semianalog/sf/README

Audio non-contact shortfinder

Still a prototype
