semianalog/sf/sf.kicad_pcb

## KiCad design sf.kicad_pcb (2017-08-20)

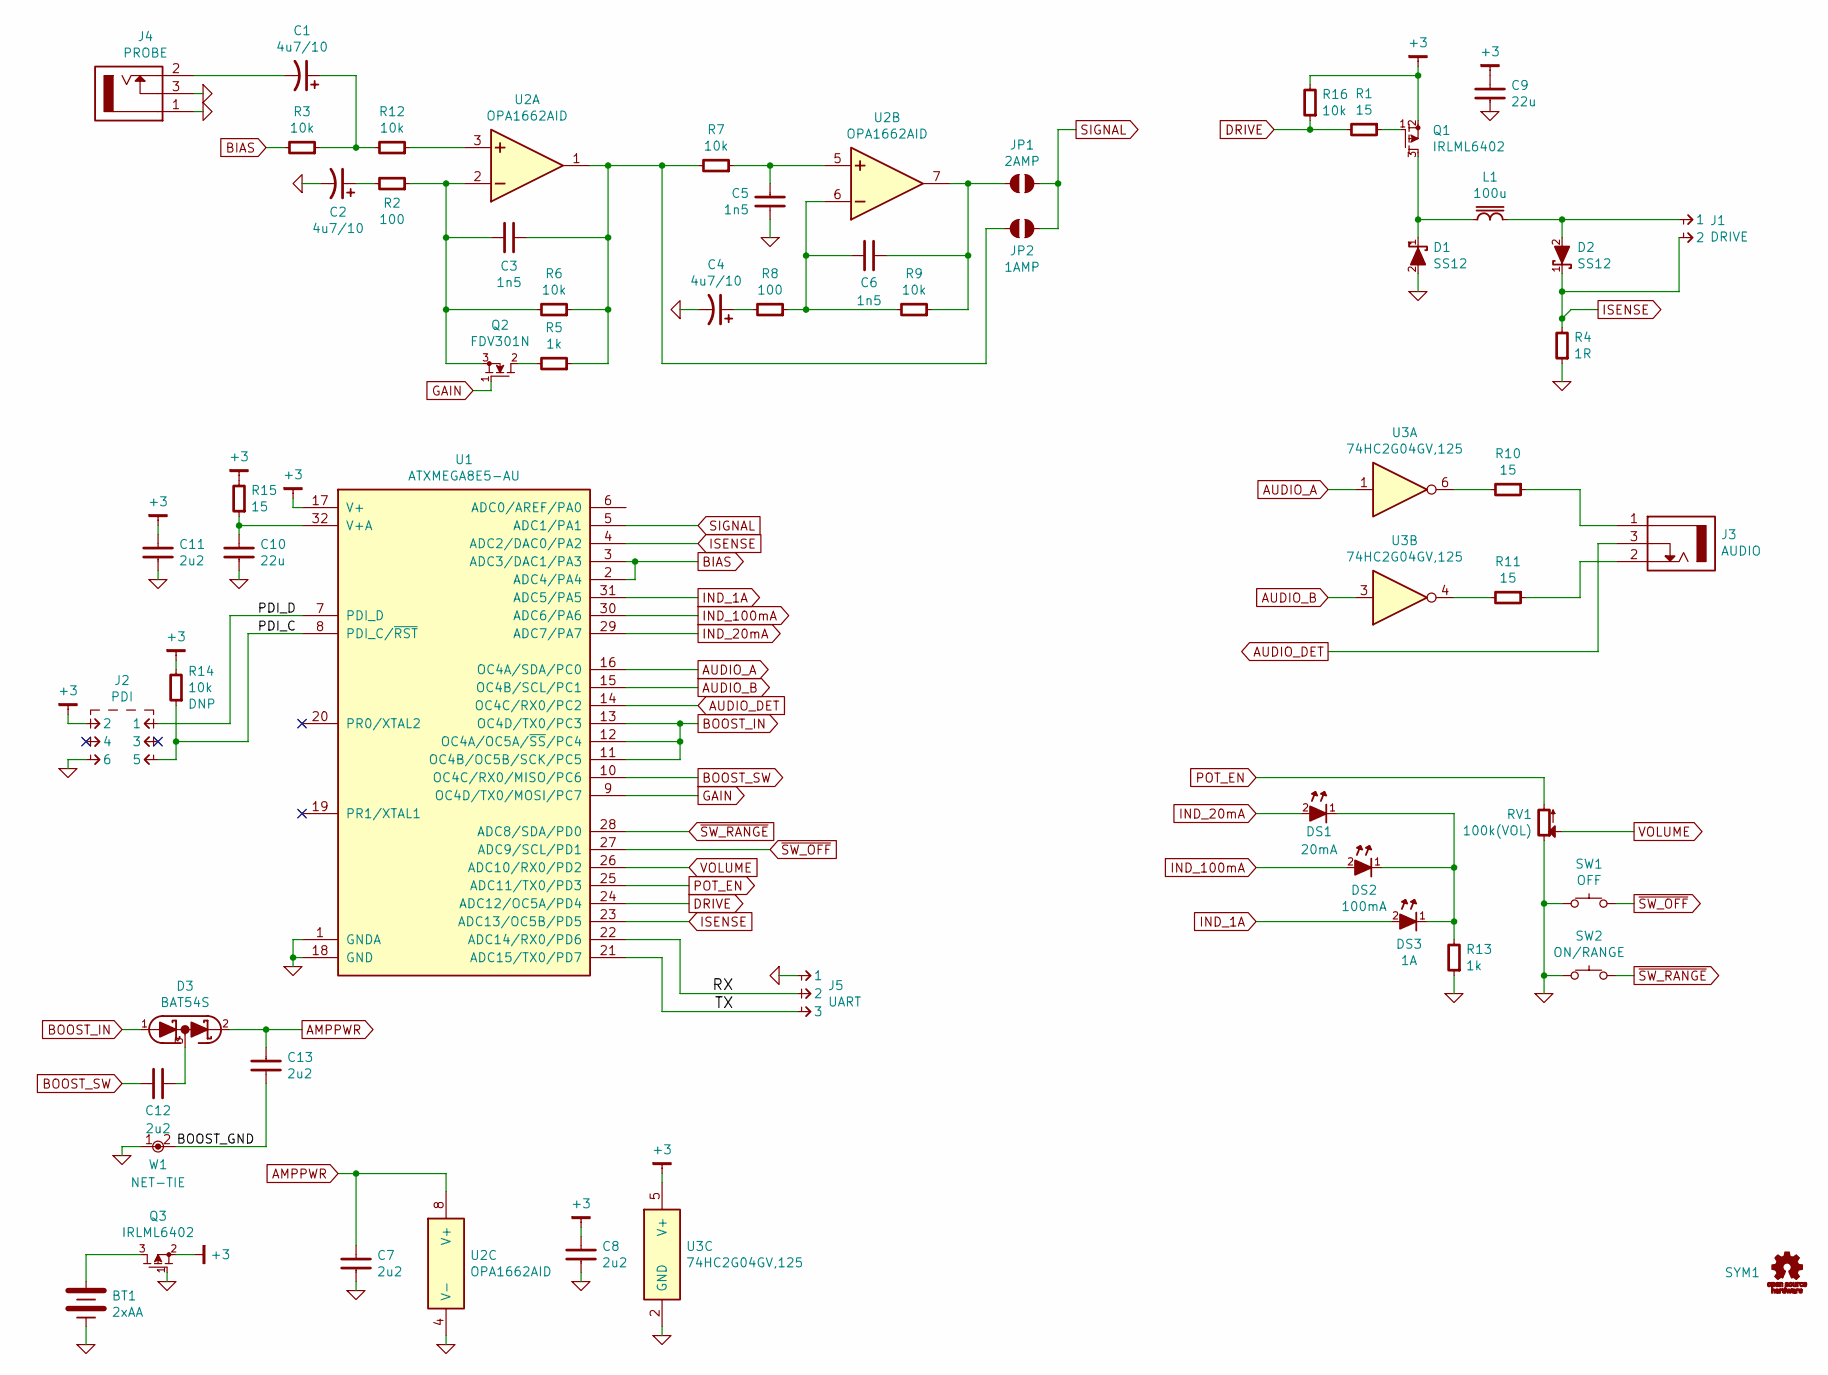
[picture p1: schematic sf.sch, Non-contact audio shortfinder]

Parts:
BT1: 2xAA
C1, C2, C4: 4u7/10; CAPMP2013X120; MPN F921A475MPA
C3, C5, C6: 1n5; CAPC2012X70
C7, C8, C11, C12, C13: 2u2; CAPC2012X70
C9, C10: 22u; CAPC3216X70
D1, D2: SS12; DIOM5326X292
D3: BAT54S; SOT-23
DS1: 20mA; LED-0603
DS2: 100mA; LED-0603
DS3: 1A; LED-0603
J1: DRIVE; CONN-100MIL-M-1x2
J2: PDI; CONN-100MIL-M-2x3
J3: AUDIO
J4: PROBE
J5: UART; CONN-100MIL-M-1x3
JP1: 2AMP; JUMPER-SOLDER-SMD
JP2: 1AMP; JUMPER-SOLDER-SMD
L1: 100u; BOURNS-RLB0914
Q1, Q3: IRLML6402; SOT-23
Q2: FDV301N; SOT-23
R1, R10, R11, R15: 15; RESC2012X50
R2, R8: 100; RESC2012X50
R3, R6, R7, R9, R12, R14, R16: 10k; RESC2012X50
R4: 1R; RESC3216X60
R5, R13: 1k; RESC2012X50
RV1: 100k(VOL); MPN 3352T-1-104LF
SW1: OFF; TE-FSMSM
SW2: ON/RANGE; TE-FSMSM
SYM1: OSHW-SCHEM-PCB6mm; OSHW-6mm
U1: ATXMEGA8E5-AU; QFP80P900X900X120-32; MPN ATXMEGA8E5-AU
U2: OPA1662AID; SOIC127P600X175-8; MPN OPA1662AID
U3: 74HC2G04GV,125; SOT-23-6; MPN 74HC2G04GV,125
W1: NET-TIE; NET-TIE-1mm

Connections:
+3: C8.1, C9.1, C11.1, J2.2, Q1.2 (S), Q3.2 (S), R14.2, R15.2, R16.2, U1.17 (V+), U3.5 (V+)
/BOOST_GND: C13.1, W1.2
/PDI_C: J2.5, R14.1, U1.8 (PDI_C/~RST)
/PDI_D: J2.1, U1.7 (PDI_D)
/RX: J5.2, U1.22 (ADC14/RX0/PD6)
/TX: J5.3, U1.21 (ADC15/TX0/PD7)
AMPPWR: C7.1, C13.2, D3.2 (K), U2.8 (V+)
AUDIO_A: U1.16 (OC4A/SDA/PC0), U3.1
AUDIO_B: U1.15 (OC4B/SCL/PC1), U3.3
AUDIO_DET: J3.3, U1.14 (OC4C/RX0/PC2)
BIAS: R3.2, U1.2 (ADC4/PA4), U1.3 (ADC3/DAC1/PA3)
BOOST_IN: D3.1 (A), U1.11 (OC4B/OC5B/SCK/PC5), U1.12 (OC4A/OC5A/~SS~/PC4), U1.13 (OC4D/TX0/PC3)
BOOST_SW: C12.2, U1.10 (OC4C/RX0/MISO/PC6)
DRIVE: R1.2, R16.1, U1.24 (ADC12/OC5A/PD4)
GAIN: Q2.1 (G), U1.9 (OC4D/TX0/MOSI/PC7)
GND: BT1.2 (-), C2.2, C4.2, C5.1, C7.2, C8.2, C9.2, C10.2, C11.2, D1.2 (A), J2.6, J4.1, J4.3, J5.1, Q3.1 (G), R4.1, R13.1, RV1.1, SW1.1, SW2.1, U1.1 (GNDA), U1.18 (GND), U2.4 (V-), U3.2 (GND), W1.1
IND_1A: DS3.2 (A), U1.31 (ADC5/PA5)
IND_20mA: DS1.2 (A), U1.29 (ADC7/PA7)
IND_100mA: DS2.2 (A), U1.30 (ADC6/PA6)
ISENSE: D2.1 (K), J1.2, R4.2, U1.4 (ADC2/DAC0/PA2), U1.23 (ADC13/OC5B/PD5)
unnamed: BT1.1 (+), Q3.3 (D)
unnamed: C1.1, R3.1, R12.2
unnamed: C1.2, J4.2
unnamed: C2.1, R2.2
unnamed: C3.1, JP2.1, R5.1, R6.1, R7.2, U2.1 (OUT)
unnamed: C3.2, Q2.3 (S), R2.1, R6.2, U2.2 (IN-)
unnamed: C4.1, R8.2
unnamed: C5.2, R7.1, U2.5 (IN+)
unnamed: C6.1, JP1.1, R9.1, U2.7 (OUT)
unnamed: C6.2, R8.1, R9.2, U2.6 (IN-)
unnamed: C10.1, R15.1, U1.32 (V+A)
unnamed: C12.1, D3.3 (COM)
unnamed: D1.1 (K), L1.2, Q1.3 (D)
unnamed: D2.2 (A), J1.1, L1.1
unnamed: DS1.1 (K), DS2.1 (K), DS3.1 (K), R13.2
unnamed: J3.1, R10.1
unnamed: J3.2, R11.1
unnamed: Q1.1 (G), R1.1
unnamed: Q2.2 (D), R5.2
unnamed: R10.2, U3.6
unnamed: R11.2, U3.4
unnamed: R12.1, U2.3 (IN+)
POT_EN: RV1.3, U1.25 (ADC11/TX0/PD3)
SIGNAL: JP1.2, JP2.2, U1.5 (ADC1/PA1)
VOLUME: RV1.2, U1.26 (ADC10/RX0/PD2)
~SW_OFF: SW1.2, U1.27 (ADC9/SCL/PD1)
~SW_RANGE: SW2.2, U1.28 (ADC8/SDA/PD0)

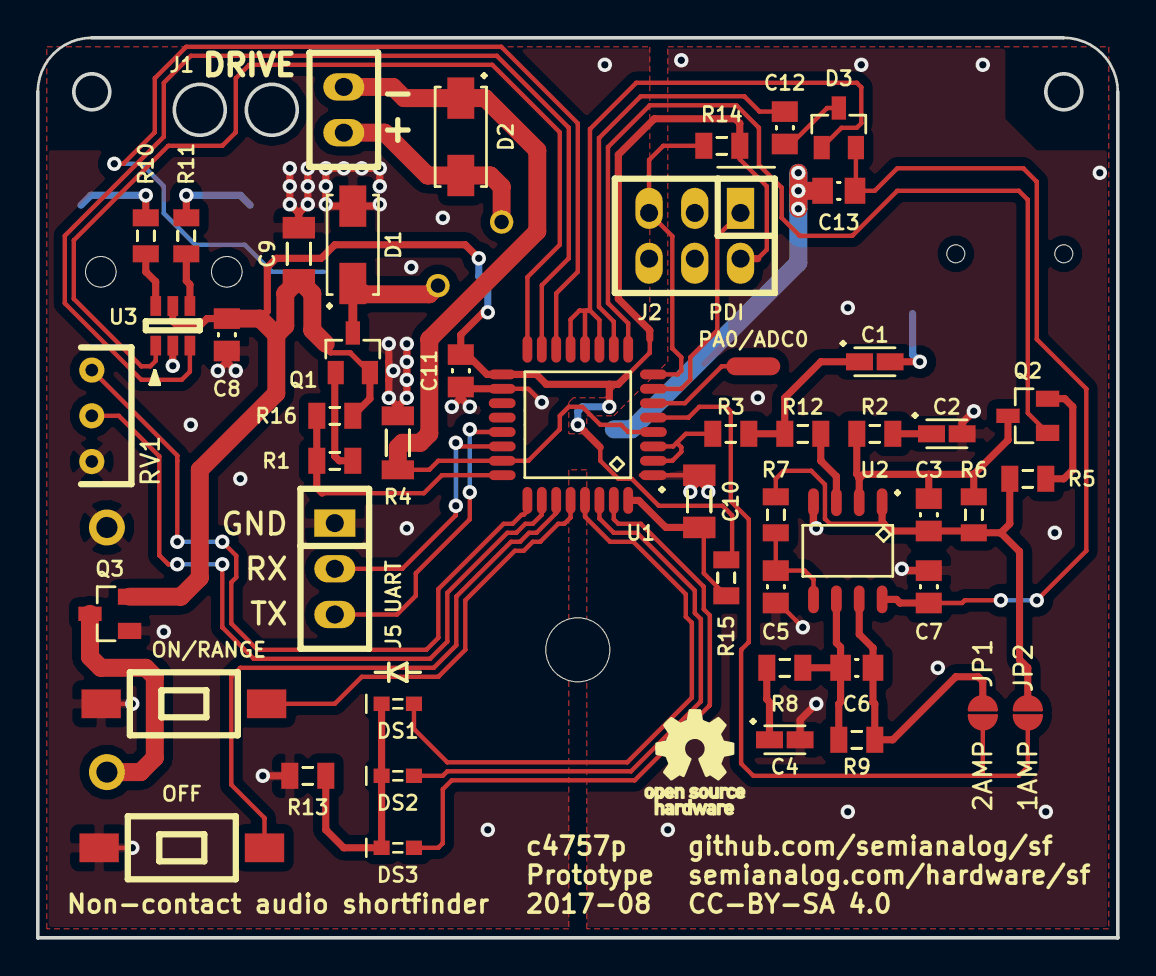
[picture p2: board sf.kicad_pcb from above]

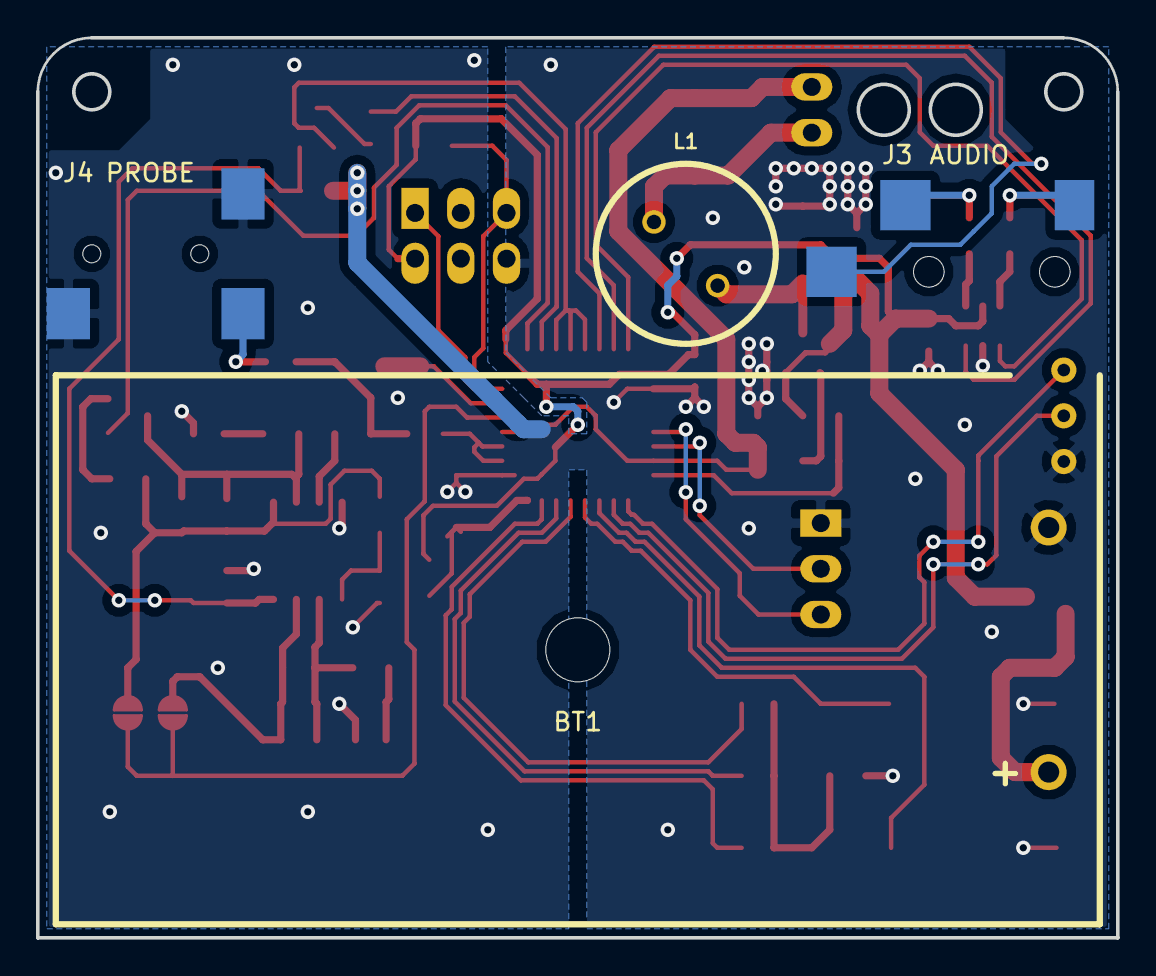
[picture p3: board sf.kicad_pcb from below]

Board: 2 copper layers, 60.0 x 50.0 mm, 55 parts (5 on the bottom side), 47 nets.
