semianalog/sf/instructions/main-assy.odt

BT1 Battery holder, 2x AA BC2AAPC-ND

Included separately

C1, C2, C4 Cap, Tantalum, 4.7µF [0805] 478-8125-1-ND

Polarized (match PCB mark to part mark)

C3, C5, C6 Cap, Ceramic, 1.5nF [0805] 1276-1794-1-ND

C7, C8, C11, C12, C13 Cap, Ceramic, 2.2µF [0805] 587-1293-1-ND

C9, C10 Cap, Ceramic, 22µF, [1206] 399-8183-1-ND

D1, D2 Diode, Schottky, 1A SS12-E3/61TGICT-ND

Polarized (match PCB mark to part mark)

D3 Diode, dual Schottky BAT54SFSCT-ND

DS1, DS2, DS3 LED, red SML-D12U1WT86CT-ND

Polarized (match diode symbol on PCB to symbol on back of part)

J3 3.5mm mono phone jack CP-3523MJCT-ND

Connector for headphones

J4 2.5mm mono phone jack CP-2523MJCT-ND

Connector for magnetic loop probe

J4(p) 2.5mm mono phone plug CP3-1004-ND

Connector for magnetic loop probe - see probe construction guide

L1 100uH inductor RLB0914-101KL-ND

Q1, Q3 P-channel MOSFET, 3.7A IRLML6402PBFCT-ND

Q2 Low threshold N-channel MOSFET FDV301NCT-ND

R1, R10, R11, R15 Res, 15 ohm 5% [0805] RMCF0805JT15R0CT-ND

R2, R8 Res, 100 ohm, 1%, [0805] 311-100CRCT-ND

R3, R6, R7, R9, R12, R16 Res, 10k ohm, 1%, [0805] 311-10.0KCRCT-ND

R4 Res, 1 ohm 5% [1206] 1276-5843-1-ND

R5, R13 Res, 1k ohm, 1% [0805] 311-1.00KCRCT-ND

R14: DO NOT POPULATE

RV1 Pot, 100k ohm 3352T-104LF-ND

Leads bent for packing; bend back gently

SW1, SW2 Switch, tactile 450-1140-ND

U1 Microcontroller, XMEGA (AVR) ATXMEGA32E5-AU-ND

Flashed with bootloader https://github.com/alexforencich/xboot

U2 Dual op-amp, low noise OPA1662 296-36692-1-ND

U3 Dual logic inverter, 74HC04 1727-6914-1-ND
