semianalog/sf/(commit log)

2017-09-02 Some power management stuff
2017-09-03 Start timer
2017-09-07 Configure "power on" button
2017-09-07 Divide Clk_CPU by 4 for lower power.
    Clk_PER4 is still 32MHz and is used for the hi-res PWM extension.
2017-09-08 Boot into power-off
2017-09-09 Add current source control
2017-09-09 Initial assembly instructions
2017-09-09 Early ADC bringup
2017-09-10 Add event system ADC trigger
2017-09-10 Calibrate ADC
2017-09-10 Add notes for rev B
    - Quieter inductor
    - ADC reference is VCC/1.6, account for that in volpot
    - Volume pot sucks
    [sf.sch]
2017-09-14 Update assembly instructions and schematic notes
    [sf.sch]
